cwalther/bristlebot-pcb/instructions/IMG_0908.jpeg

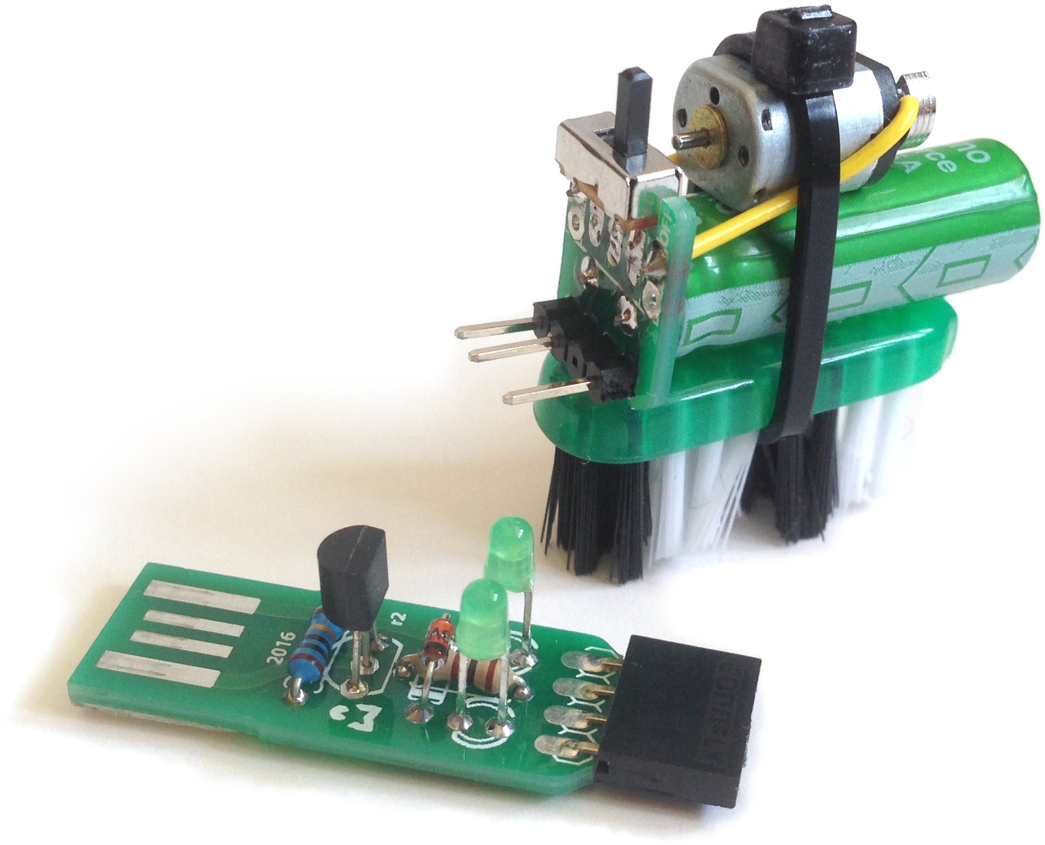
instructions/IMG_0908.jpeg
