cwalther/bristlebot-pcb/instructions/IMG_0900.jpeg

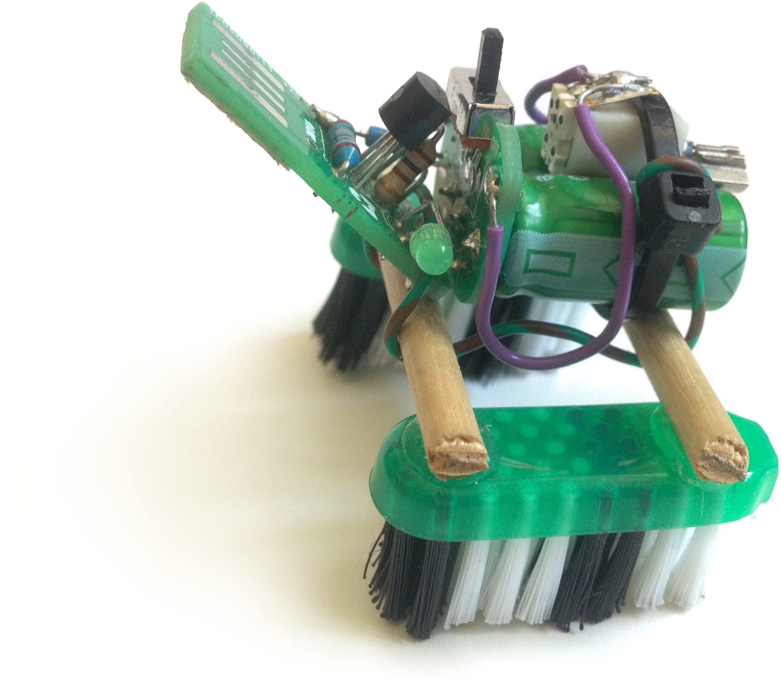
instructions/IMG_0900.jpeg
