cwalther/bristlebot-pcb/README.md

# Capacitor-Powered Bristlebot Kit

Eagle PCB files for
[http://wiki.fablabwinti.ch/Capacitor-Powered_Bristlebot_Kit](http://wiki.fablabwinti.ch/Capacitor-Powered_Bristlebot_Kit).

© 2016 Christian Walther, licensed [CC BY-SA 4.0](http://creativecommons.org/licenses/by-sa/4.0/).
