cwalther/bristlebot-pcb/instructions/overview-r2.jpeg

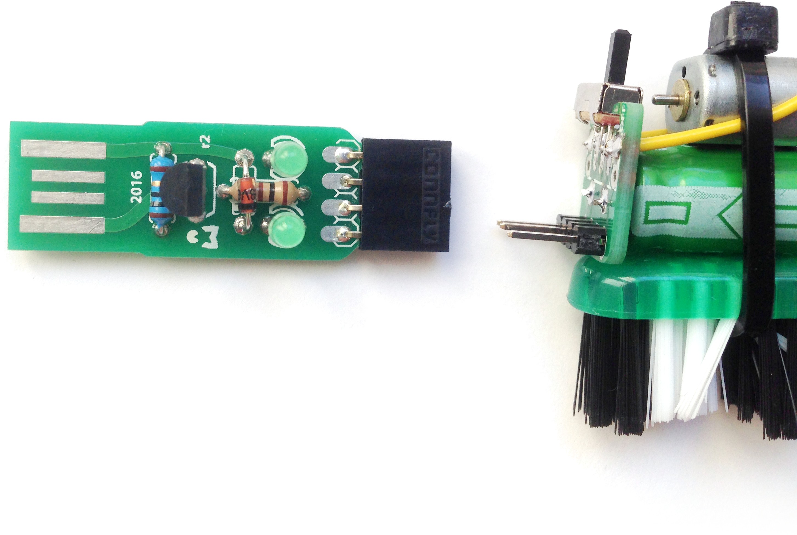
instructions/overview-r2.jpeg
