cwalther/bristlebot-pcb/pcb/capbot.brd

## EAGLE design pcb/capbot.brd (2016-08-11)

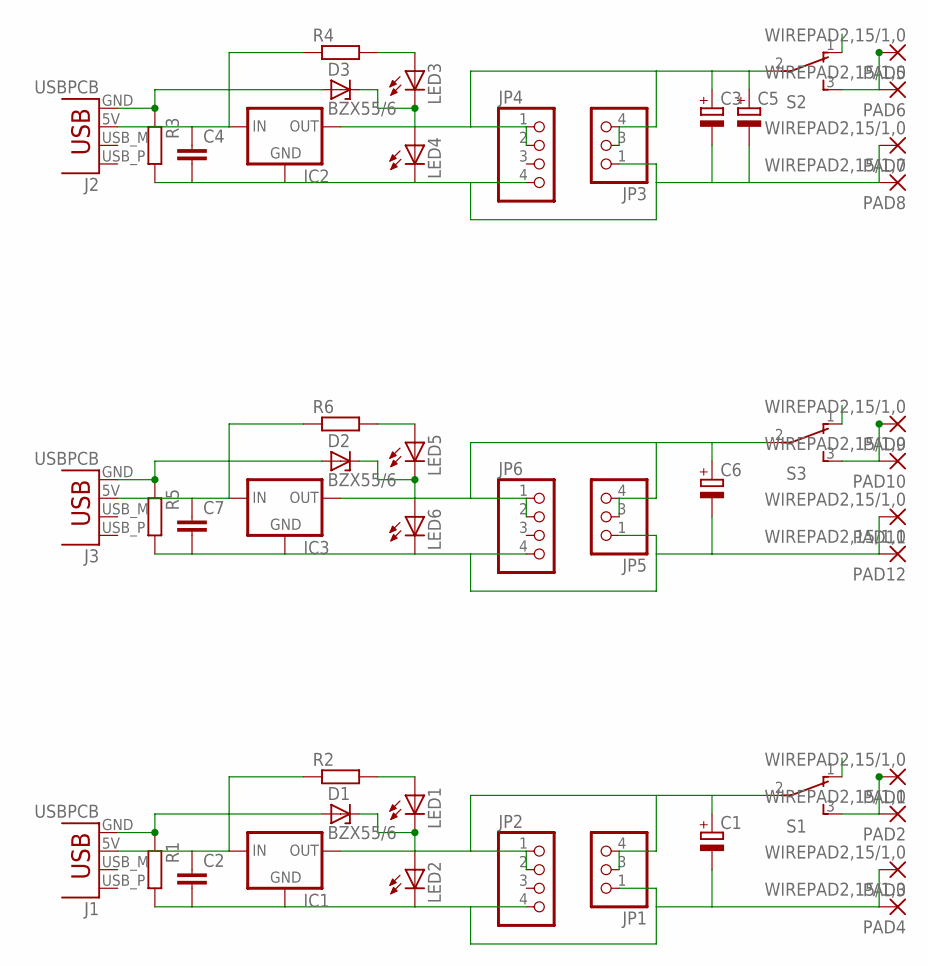
[picture p4: schematic capbot.sch]

Parts:
C1, C3, C5, C6: CPOL-EUE5-10.5; E5-10,5
C2, C4, C7: C-EUC1206; C1206
D1, D2, D3: BZX55/6; DO35Z6
IC1, IC2, IC3: MCP1700INLINE; TO92-INLINE
J1, J2, J3: USBPCB; USB-A-PCB
JP1, JP3, JP5: PINHD-1X3-4GAP; 1X04/GAP2
JP2, JP4, JP6: PINHD-1X4; 1X04/OFFSETDOWN
LED1, LED2, LED3, LED4, LED5, LED6: LED3MM-MOREFLAT
PAD1, PAD2, PAD3, PAD4, PAD5, PAD6, PAD7, PAD8, PAD9, PAD10, PAD11, PAD12: WIREPAD2,15/1,0; 2,15/1,0
R1, R2, R3, R4, R5, R6: R-EU_0207/7; 0207/7
S1, S2, S3: TL36PO; TL3XPO

Connections:
unnamed: C1.-, C2.2, IC1.1 (GND), JP1.1, JP2.4, LED2.K (C), PAD3.1, PAD4.1, R1.2
unnamed: C1.+, IC1.3 (OUT), JP1.3 (2), JP1.4 (3), JP2.1, JP2.2, S1.2
unnamed: PAD1.1, PAD2.1, S1.3 (S)
unnamed: D1.A, J1.GND, R1.1
unnamed: C2.1, IC1.2 (IN), J1.5V (VBUS), R2.1
unnamed: LED1.A, R2.2
unnamed: D1.C, LED1.K (C), LED2.A
unnamed: C3.-, C4.2, C5.-, IC2.1 (GND), JP3.1, JP4.4, LED4.K (C), PAD7.1, PAD8.1, R3.2
unnamed: C3.+, C5.+, IC2.3 (OUT), JP3.3 (2), JP3.4 (3), JP4.1, JP4.2, S2.2
unnamed: PAD5.1, PAD6.1, S2.3 (S)
unnamed: D3.A, J2.GND, R3.1
unnamed: C4.1, IC2.2 (IN), J2.5V (VBUS), R4.1
unnamed: LED3.A, R4.2
unnamed: D3.C, LED3.K (C), LED4.A
unnamed: C6.-, C7.2, IC3.1 (GND), JP5.1, JP6.4, LED6.K (C), PAD11.1, PAD12.1, R5.2
unnamed: C6.+, IC3.3 (OUT), JP5.3 (2), JP5.4 (3), JP6.1, JP6.2, S3.2
unnamed: PAD9.1, PAD10.1, S3.3 (S)
unnamed: D2.A, J3.GND, R5.1
unnamed: C7.1, IC3.2 (IN), J3.5V (VBUS), R6.1
unnamed: LED5.A, R6.2
unnamed: D2.C, LED5.K (C), LED6.A

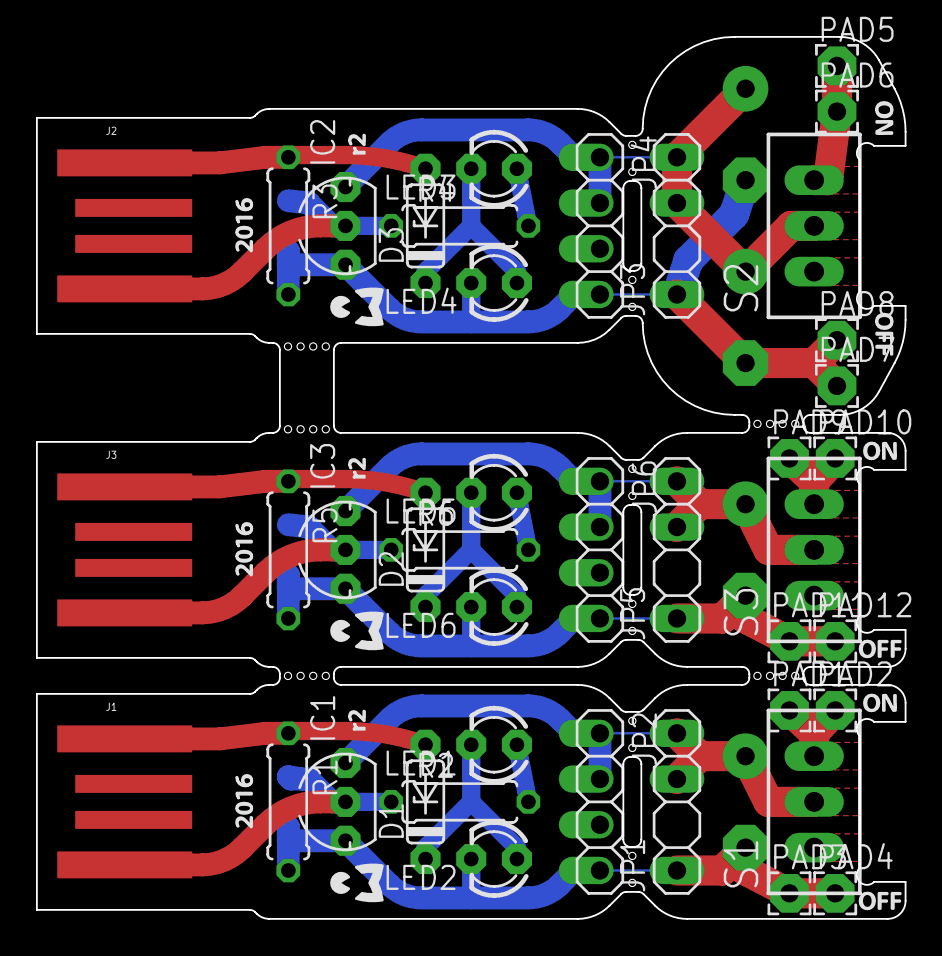
[picture p5: board capbot.brd from above]

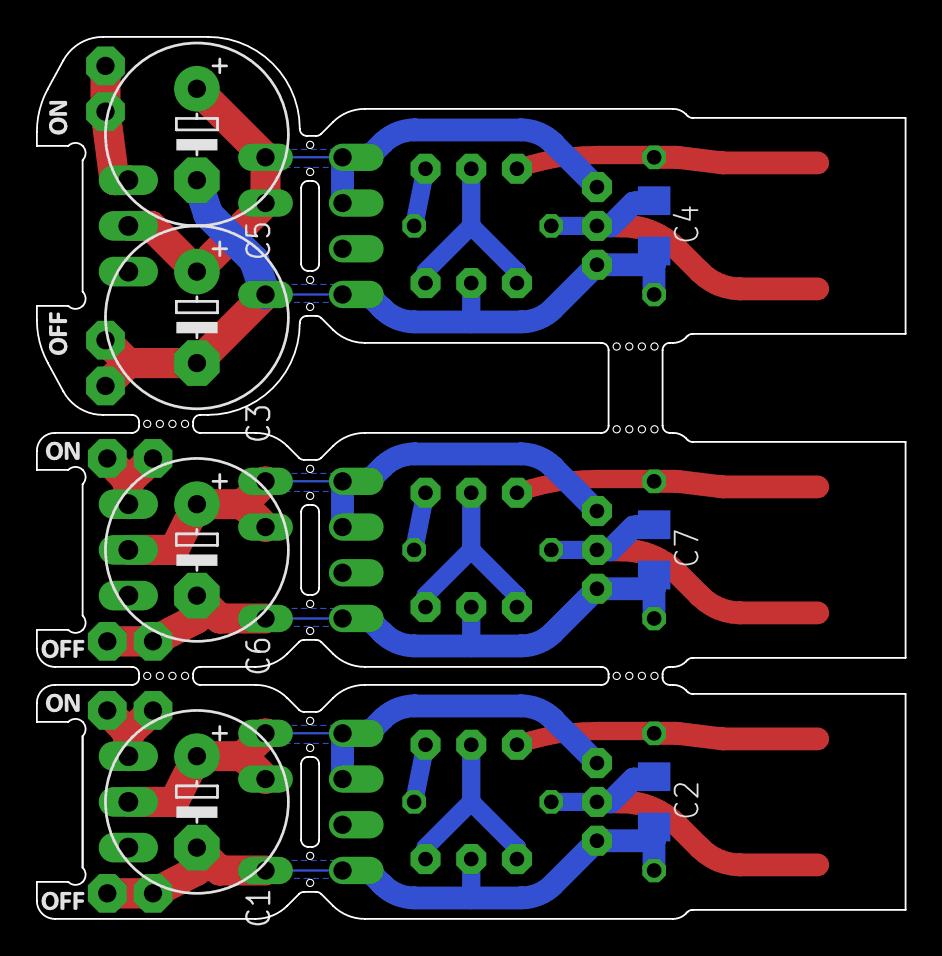
[picture p6: board capbot.brd from below]

Board: 2 copper layers, 48.3 x 49.0 mm, 70 parts (13 on the bottom side), 21 nets.

Other parts of the board:
U$1, U$2, U$8: CWLOGO-3
U$3, U$5, U$9: 2016
U$7, U$12, U$14, U$16, U$18, U$20: OFF
U$11, U$13, U$15, U$17, U$19, U$21: ON
U$22, U$23, U$24: R2
