cwalther/bristlebot-pcb/instructions/instructions.pdf

# Bristlebot-Stromversorgung mit USB-Ladestation

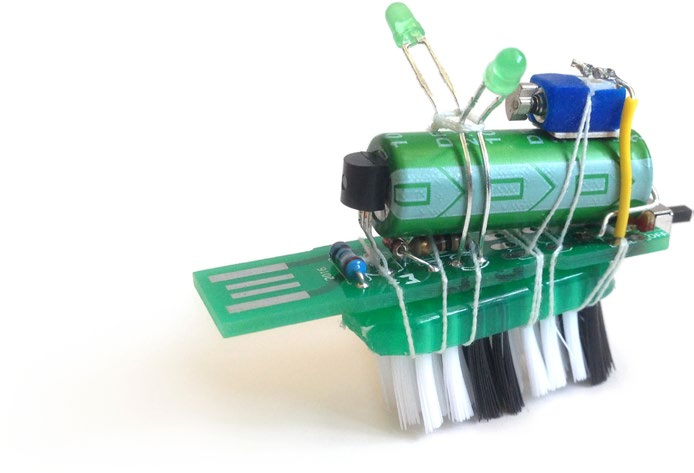
[picture p7: figure]
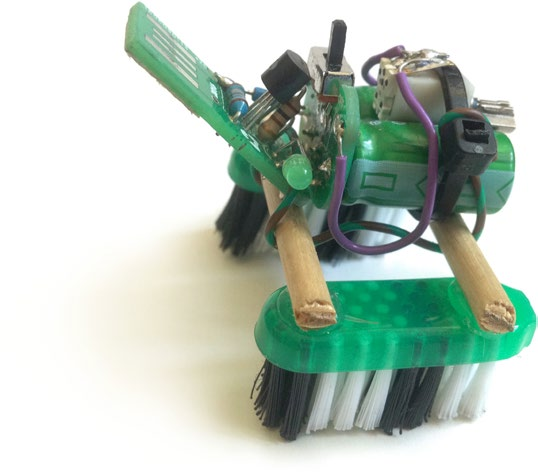
[picture p8: figure]
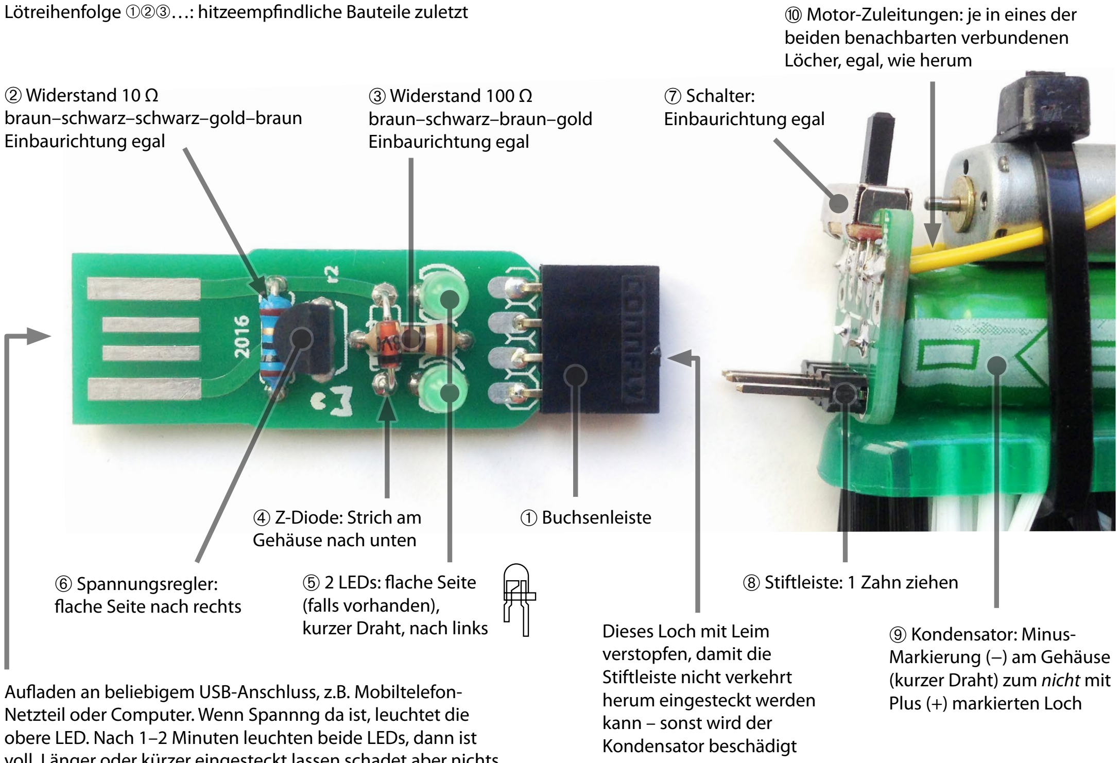
[picture p9: figure]
Lötreihenfolge ➀➁➂…: hitzeempfindliche Bauteile zuletzt; ➀ Buchsenleiste; Dieses Loch mit Leim verstopfen, damit die Stiftleiste nicht verkehrt herum eingesteckt werden kann – sonst wird der Kondensator beschädigt; ➁ Widerstand 10 Ω braun–schwarz–schwarz–gold–braun Einbaurichtung egal; ➂ Widerstand 100 Ω braun–schwarz–braun–gold Einbaurichtung egal; ➄ 2 LEDs: flache Seite (falls vorhanden), kurzer Draht, nach links; ➃ Z-Diode: Strich am Gehäuse nach unten; ➅ Spannungsregler: flache Seite nach rechts; ➆ Schalter: Einbaurichtung egal; ➇ Stiftleiste: 1 Zahn ziehen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

Mehr: http://wiki.fablabwinti.ch/Capacitor-Powered_Bristlebot_Kit

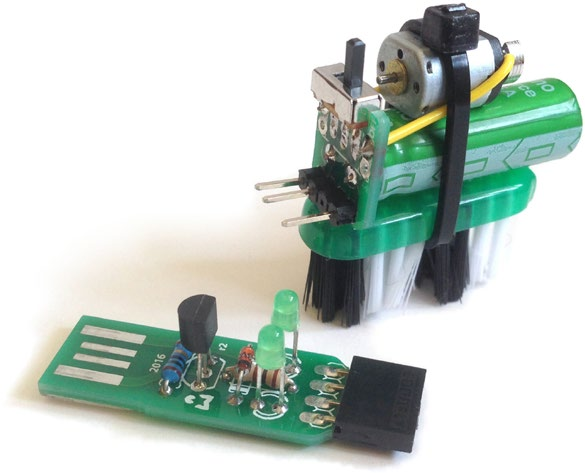
[picture p10: figure]

Aufladen an beliebigem USB-Anschluss, z.B. Mobiltelefon-Netzteil oder Computer. Wenn Spannng da ist, leuchtet die obere LED. Nach 1–2 Minuten leuchten beide LEDs, dann ist voll. Länger oder kürzer eingesteckt lassen schadet aber nichts. Der Kondensator kann beliebig viele Male und in beliebigem Zustand aufgeladen werden, egal ob leergefahren oder nicht. Wenn der Kontakt schlecht ist: mit einigen Schichten Klebband auf der Unterseite auf höchstens 2 mm verdicken.

Soll die Ladestation separat oder fest am Bristlebot eingebaut sein? Je nachdem, die Platine:

Entweder auseinanderbrechen und mit
Buchsenleiste und Stiftleiste steckbar
verbinden…

… oder auseinanderbrechen und mit 2 Drähten oder Stiften der Stiftleiste fest zusammenlöten…

… oder am Stück lassen (keine Drahtverbindung nötig, es gibt Leiterbahnen über die Bruchstelle).

FabLab Winti 5.6.2017 Christian Walther cwalther@gmx.ch
