cwalther/bristlebot-pcb/(commit log)

2016-08-06 WIP 1
    [capbot.brd, capbot.sch]
2016-08-10 Stretch the charger part by 0.2 in.
    This goes against my natural tendency to make things as small as possible, but in this case the added length has some advantages:
    - It allows the use of a straight instead of angled pin header if desired, without the switch getting in the way of the USB port.
    - It makes things a bit easier to solder for beginners.
    [capbot.brd]
2016-08-10 Move the pin header 0.8 mm closer to the edge so that the horizontal part of the wires can sit flush to the surface with less bending and filing.
    This required changing the pads from "long" to "offset" to prevent them from getting too close to the edge. Unfortunately it seems a pad can only be offset all the way, the drill position is not continuously adjustable - I'd have preferred something in between.
    [capbot.brd, capbot.sch]
2016-08-10 Enlarge the solder pads of the LEDs a little to make them easier to solder.
    They are the same size as the ones of the voltage regulator now.
    Curiously enough, the resistors had the same pad size but I didn't find them as problematic. Leaving them alone for now.
    [capbot.brd, capbot.sch]
2016-08-11 Add power LED function.
    With one added Zener diode, the top LED indicates that the device is powered, while both LEDs together still indicate that charging is completed.
    [capbot.brd, capbot.sch]
2016-08-11 Get rid of a via by using an existing hole, and some other prettifications.
    [capbot.brd]
2016-08-11 Replace the zero-line-width silkscreen polygons by ones made for 0.15 mm line width.
    Previously, they needlessly inflated the Gerber file size because Eagle apparently uses lines of the same width as the outline to fill them, resulting in ten-thousands of zero-width lines. The manufacturing also used a greater width (probably 0.15 mm), expanding the shapes.
    [capbot.brd]
2017-07-10 Move PCB files to subfolder.
    [capbot.brd, capbot.sch]
